brianschiffer/opencamera/README.md

# opencamera
an open hardware CCD camera
