brianschiffer/opencamera/KiCad/Power_Board/BOM.xlsx

REFDES | Count | Supplier | Supplier # | Part # | Description | Footprint | Part Count | Order Quantity | Spares | Boards Possible | Price | Board Total | Order Total
U4,U5,U6,U9 | 4 | Digikey | 296-39460-1-ND | TPS63030 | Buck-Boost Regulator with Vout=1.2 to 5.5V | CUSTOM (TPS63030) | 4 | 10 | 6 | 2 | $2.25 | $9.00 | $22.50
U8 | 1 | Digikey | ADP5070ACPZ-R7CT-ND | ADP5070 | +/-16V Boost Regulator | CUSTOM (ADP5070) | 1 | 2 | 1 | 2 | $5.99 | $5.99 | $11.98
U10 | 1 | Mouser | 584-ADP7142ACPZN-R7 | ADP7142 | LDO for 15V Line | CUSTOM (ADP7142) | 1 | 2 | 1 | 2 | $3.06 | $3.06 | $6.12
U11 | 1 | Mouser | 584-ADP7182ACPZ-R7 | ADP7182 | LDO for -15V line | CUSTOM (ADP7182) | 1 | 2 | 1 | 2 | $3.65 | $3.65 | $7.30
U12 | 1 | Digikey | ADP3335ACPZ-5-R7CT-ND | ADP3335 | 5V LDO | CUSTOM (ADP3335) | 1 | 2 | 1 | 2 | $2.76 | $2.76 | $5.52
U7 | 1 | Digikey | MAX1523EUT+TCT-ND | MAX1523 | 50V Boost | CUSTOM (SOT_623) | 1 | 2 | 1 | 2 | $3.84 | $3.84 | $7.68
U2,U3 | 2 | Digikey | MAX5259EEE+-ND | MAX5259 | 8 Channel 8bit DAC | CUSTOM (QSOP_16) | 2 | 4 | 2 | 2 | $2.82 | $5.64 | $11.28
U1 | 1 | Digikey | AD1583BRTZ-REEL7CT-ND | AD1583 | 3V Vref for DAC and Op-Amps | SOT_323 | 1 | 2 | 1 | 2 | $2.27 | $2.27 | $4.54
Q1 | 1 | Digikey | IRLL024NPBFCT-ND | IRLL024NTRPBF | N-Fet | SOT_223 | 1 | 3 | 2 | 3 | $0.93 | $0.93 | $2.79
D1,D3 | 2 | Digikey | DFLS240LDICT-ND | DFLS240 | Zener Diode | CUSTOM (DFLS240) | 2 | 5 | 3 | 2 | $0.46 | $0.92 | $2.30
D2 | 1 | Digikey | 1N4148WSFSCT-ND | 1N4148 | Diode | CUSTOM (1N4148) | 1 | 10 | 9 | 10 | $0.15 | $0.15 | $1.46
D4 | 1 | Digikey | 1N5261B-ND | 1N5261 | Diode | DO-35 | 1 | 10 | 9 | 10 | $0.12 | $0.12 | $1.17
L1,L2,L3, L5,L7 | 5 | Digikey | 587-3459-1-ND | NRS5030T3R3MMGJ | 3.3uH Inductor | CUSTOM (NRS5030) | 5 | 10 | 5 | 2 | $0.41 | $2.05 | $4.10
L6 | 1 | Digikey | 587-3462-1-ND | NRS5030T6R8MMGJ | 6.8uH Inductor | CUSTOM (NRS5030) | 1 | 3 | 2 | 3 | $0.46 | $0.46 | $1.38
L4 | 1 | Digikey | 587-2731-1-ND | NS12555T470MN | 47uH Inductor | CUSTOM (NS12555) | 1 | 2 | 1 | 2 | $1.41 | $1.41 | $2.82
R9,R10,R11,R22,R23,R30,R31,R32 | 8 | Digikey | 541-0.0TBCT-ND | CRCW08050000Z0EAHP | 0ohm Jumper | 0805 | 8 | 50 | 42 | 6 | $0.15 | $1.18 | $7.40
R28 | 1 | Digikey | 541-1.00KLCT-ND | CRCW04021K00FKED | 1k Resistor (1% 1/16W) | 0402 | 1 | 10 | 9 | 10 | $0.08 | $0.08 | $0.83
R12 | 1 | Digikey | 541-5.60KLCT-ND | CRCW04025K60FKED | 5.6k Resistor (1% 1/16W) | 0402 | 1 | 10 | 9 | 10 | $0.08 | $0.08 | $0.83
R1,R2,R26 | 3 | Digikey | 541-10.0KLCT-ND | CRCW040210K0FKED | 10k Resistor (1% 1/16W) | 0402 | 3 | 10 | 7 | 3 | $0.08 | $0.25 | $0.83
R13 | 1 | Digikey | 541-12.0KLCT-ND | CRCW040212K0FKED | 12k Resistor (1% 1/16W) | 0402 | 1 | 10 | 9 | 10 | $0.08 | $0.08 | $0.83
R24,R29 | 2 | Digikey | 541-13.0KLCT-ND | CRCW040213K0FKED | 13k Resistor (1% 1/16W) | 0402 | 2 | 10 | 8 | 5 | $0.08 | $0.17 | $0.83
R15 | 1 | Digikey | 541-100KLCT-ND | CRCW0402100KFKED | 100k Resistor (1% 1/16W) | 0402 | 1 | 10 | 9 | 10 | $0.08 | $0.08 | $0.83
R14 | 1 | Digikey | 541-113KLCT-ND | CRCW0402113KFKED | 113k Resistor (1% 1/16W) | 0402 | 1 | 10 | 9 | 10 | $0.08 | $0.08 | $0.83
R20 | 1 | Mouser | 71-CRCW0402-115K-E3 | CRCW0402115KFKED | 115k Resistor (1% 1/16W) | 0402 | 1 | 10 | 9 | 10 | $0.04 | $0.04 | $0.45
R27 | 1 | Digikey | 541-147KLCT-ND | CRCW0402147KFKED | 147k Resistor (1% 1/16W) | 0402 | 1 | 10 | 9 | 10 | $0.08 | $0.08 | $0.83
R6,R4 | 2 | Digikey | 541-200KLCT-ND | CRCW0402200KFKED | 200k Resistor (1% 1/16W) | 0402 | 2 | 10 | 8 | 5 | $0.08 | $0.17 | $0.83
R8,R18 | 2 | Digikey | 541-210KLCT-ND | CRCW0402210KFKED | 210k Resistor (1% 1/16W) | 0402 | 2 | 10 | 8 | 5 | $0.08 | $0.17 | $0.83
R21 | 1 | Digikey | 541-300KLCT-ND | CRCW0402300KFKED | 300k Resistor (1% 1/16W) | 0402 | 1 | 10 | 9 | 10 | $0.08 | $0.08 | $0.83
R3,R20 | 2 | Digikey | 541-523KLCT-ND | CRCW0402523KFKED | 523k Resistor (1% 1/16W) | 0402 | 2 | 10 | 8 | 5 | $0.08 | $0.17 | $0.83
R7 | 1 | Digikey | 541-1.20MLCT-ND | CRCW04021M20FKED | 1.2M Resistor (1% 1/16W) | 0402 | 1 | 10 | 9 | 10 | $0.08 | $0.08 | $0.83
R5 | 1 | Digikey | 541-1.80MLCT-ND | CRCW04021M80FKED | 1.8M Resistor (1% 1/16W) | 0402 | 1 | 10 | 9 | 10 | $0.08 | $0.08 | $0.83
R17,R19 | 2 | Digikey | 541-2.10MLCT-ND | CRCW04022M10FKED | 2.1M Resistor (1% 1/16W) | 0402 | 2 | 10 | 8 | 5 | $0.08 | $0.17 | $0.83
R16 | 1 | Digikey | 541-2.15MLCT-ND | CRCW04022M15FKED | 2.15M Resistor (1% 1/16W) | 0402 | 1 | 10 | 9 | 10 | $0.08 | $0.08 | $0.83
C31 | 1 | Digikey | 490-6390-1-ND | GRM1885C2A200JA01J | 20pF Cap (5% 100V NPO) | 0603 | 1 | 10 | 9 | 10 | $0.08 | $0.08 | $0.83
C35,C36 | 2 | Digikey | 490-6349-1-ND | GRM155R71H102JA01J | 1nF Cap (5% 50V X7R) | 0402 | 2 | 10 | 8 | 5 | $0.01 | $0.02 | $0.12
C20,C21 | 2 | Digikey | 490-7762-1-ND | GRM155R71E473JA88D | 47nF Cap (5% 25V X7R) | 0402 | 2 | 10 | 8 | 5 | $0.07 | $0.14 | $0.71
C2,C5,C7,C11,C12,C13,C25,C39 | 8 | Digikey | 490-9691-1-ND | GRM188R71E104JA01J | 0.1uF Cap (5% 25V X7R) | 0603 | 8 | 50 | 42 | 6 | $0.05 | $0.37 | $2.33
C3,C4,C6,C23,C26,C32,C38 | 7 | Digikey | 490-5307-1-ND | GRM188R71E105KA12D | 1uF Cap (10% 25V X7R) | 0603 | 7 | 50 | 43 | 7 | $0.13 | $0.91 | $6.53
C34 | 1 | Digikey | 490-3909-1-ND | GRM31CR72A105KA01L | 1uF Cap (10% 100V X7R) | 1206 | 1 | 10 | 9 | 10 | $0.51 | $0.51 | $5.13
C33,C40,C41 | 3 | Digikey | 490-3331-1-ND | GRM21BR71E225KA73L | 2.2uF Cap (10% 25V X7R) | 0805 | 3 | 10 | 7 | 3 | $0.56 | $1.67 | $5.56
C1 | 1 | Digikey | 490-9962-1-ND | GRM21BR71E475KA73L | 4.7uF Cap (10% 25V X7R) | 0805 | 1 | 10 | 9 | 10 | $0.42 | $0.42 | $4.19
C8,C9,C10,C14,C15,C16,C17,C18,C19,C24,C27,C28,C37,C22,C29,C30 | 16 | Digikey | 490-6544-1-ND | GRM32ER71H106KA12L | 10uF Cap (10% 25V X7R) | 1210 | 16 | 50 | 34 | 3 | $0.42 | $6.66 | $20.80
TP1,Tp2,Tp3,TP4,TP5,TP6,TP7,TP8 | 8 | Digikey | EXAMPLE: 36-5001-ND | MANY COLORS | Test Clip (Low Profile) | CUSTOM (TEST_CLIP) | 8 | 30 | 22 | 3 | $0.33 | $2.62 | $9.81
P5,P6,P7,P8,P9,P10 | 6 | Digikey | S1133E-36-ND | GBC36SBSN-M89 | Low Profile 2pin Header | CUSTOM (SMD_JUMPER) | 6 | 1 | -5 | 0 | $5.56 | $5.56 | $5.56
Total |  |  |  |  |  |  |  |  |  |  |  | $64.35 | $175.64
