brianschiffer/opencamera/KiCad/Battery_Board/BOM.xlsx

REFDES | Count | Supplier | Supplier # | Part # | Description | Footprint | Part Count | Order Quantity | Spares | Boards Possible | Price | Board Total | Order Total
U1 | 1 | Mouser | 595-BQ24230RGTR | BQ24230 | LiPo USB-Friendly Charger w/ Power Path | CUSTOM (BQ24230) | 1 | 3 | 2 | 3 | $2.87 | $2.87 | $8.61
U2 | 1 | Mouser | 700-MAX17043G+U | MAX17043 | LiPo Host-Side Fuel Gauge | CUSTOM (MAX17043) | 1 | 3 | 2 | 3 | $2.69 | $2.69 | $8.07
D1 | 1 | Mouser | 604-APBA3010ESGC-GX | APBA3010ESGC-GX | Red-Green BiColor LED | CUSTOM(RG_LED) | 1 | 10 | 9 | 10 | $0.22 | $0.22 | $2.24
R7,R15 | 2 | Digikey | 541-0.0TBCT-ND | CRCW08050000Z0EAHP | 0ohm Jumper | 0805 | 2 | 0 | -2 | 0 | $0.15 | $0.30 | $0.00
R6 | 1 | Mouser | 71-CRCW0402-150-E3 | CRCW0402150RFKED | 150ohm Resistor (1% 1/16W) | 0402 | 1 | 10 | 9 | 10 | $0.04 | $0.04 | $0.45
R2 | 1 | Digikey | 541-1.00KLCT-ND | CRCW04021K00FKED | 1k Resistor (1% 1/16W) | 0402 | 1 | 0 | -1 | 0 | $0.08 | $0.08 | $0.00
R9,R10 | 2 | Mouser | 71-CRCW0402-1.5K-E3 | CRCW04021K50FKED | 1.5k Resistor (1% 1/16W) | 0402 | 2 | 10 | 8 | 5 | $0.04 | $0.09 | $0.45
R3 | 1 | Mouser | 71-CRCW0402-1.74K-E3 | CRCW04021K74FKED | 1.74k (1% 1/16W) | 0402 | 1 | 10 | 9 | 10 | $0.04 | $0.04 | $0.45
R1 | 1 | Digikey | 541-10.0KLCT-ND | CRCW040210K0FKED | 10k Resistor (1% 1/16W) | 0402 | 1 | 0 | -1 | 0 | $0.08 | $0.08 | $0.00
C4 | 1 | Mouser | 81-GRM39X103K25 | GRM188R71E103KA01D | 10nF Cap (10% 25V X7R) | 0603 | 1 | 10 | 9 | 10 | $0.01 | $0.01 | $0.13
C1,C3 | 2 | Digikey | 490-5307-1-ND | GRM188R71E105KA12D | 1uF Cap (10% 25V X7R) | 0603 | 2 | 0 | -2 | 0 | $0.13 | $0.26 | $0.00
C2,C5 | 2 | Digikey | 490-9962-1-ND | GRM21BR71E475KA73L | 4.7uF Cap (10% 25V X7R) | 0805 | 2 | 0 | -2 | 0 | $0.42 | $0.84 | $0.00
SW1 | 1 | Mouser | 642-GH36WW10001 | GH36W0 | Through-Hole Switch | CUSTOM(SWITCH_SPST) | 1 | 2 | 1 | 2 | $5.99 | $5.99 | $11.98
P5 | 1 | Sparkfun | PRT-08612 | PRT-08612 | JST LiPo Connector | CUSTOM(JST-2) | 1 | 4 | 3 | 4 | $0.95 | $0.95 | $3.80
USB1 | 1 | Mouser | 798-ZX62-B-5PA11 | ZX62-B-5PA(11) | Micro USB B Receptacle | CUSTOM(MicroUBS-B-Receptacle) | 1 | 10 | 9 | 10 | $0.69 | $0.69 | $6.90
Battery | 1 | Sparkfun | PRT-00339 | PRT-00339 | 1000mAh LiPo Battery | NONE | 1 | 2 | 1 | 2 | $9.95 | $9.95 | $19.90
Total | 1 |  |  |  |  |  |  |  |  |  |  | $25.11 | $62.98
