brianschiffer/opencamera/KiCad/Driver_Board/Driver_Board.kicad_pcb

## KiCad design KiCad/Driver_Board/Driver_Board.kicad_pcb (2015-12-30)

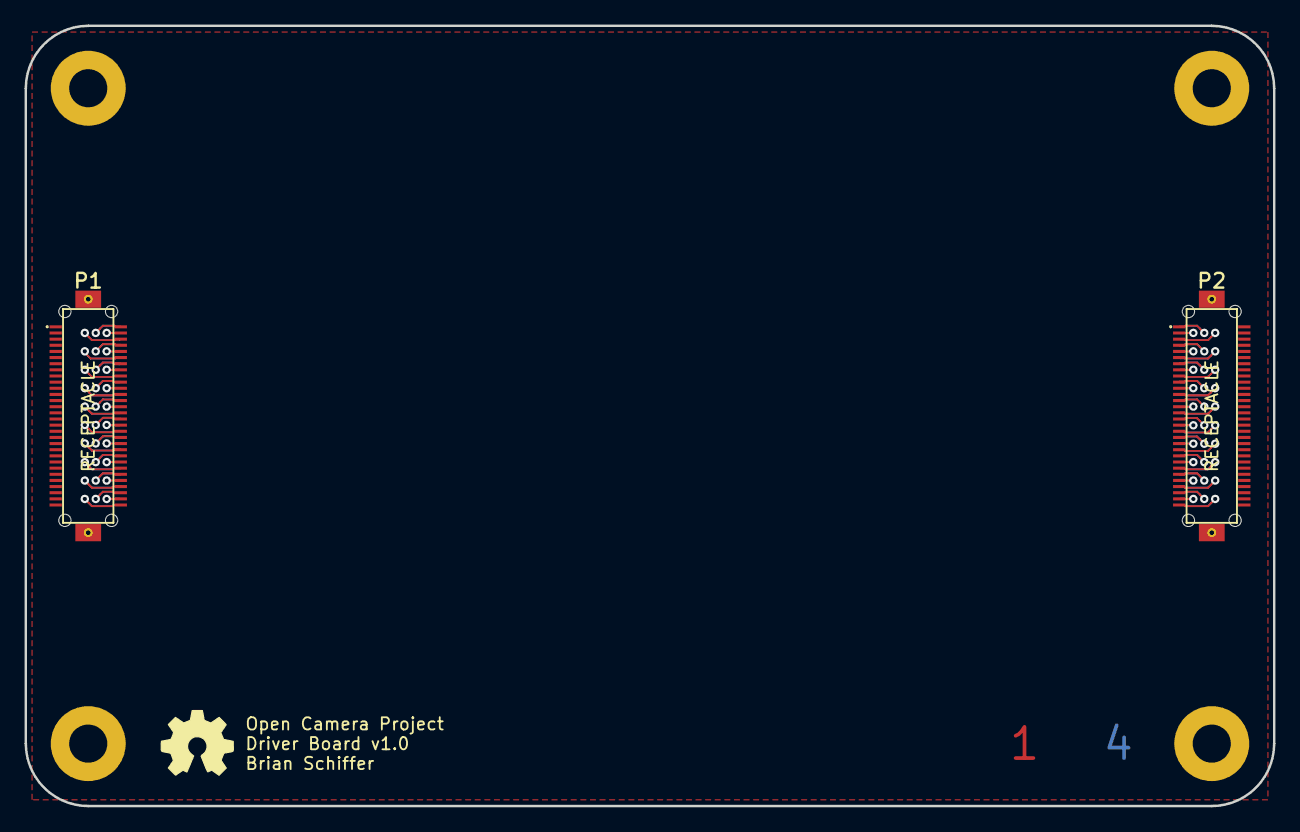
[picture p1: board Driver_Board.kicad_pcb from above]

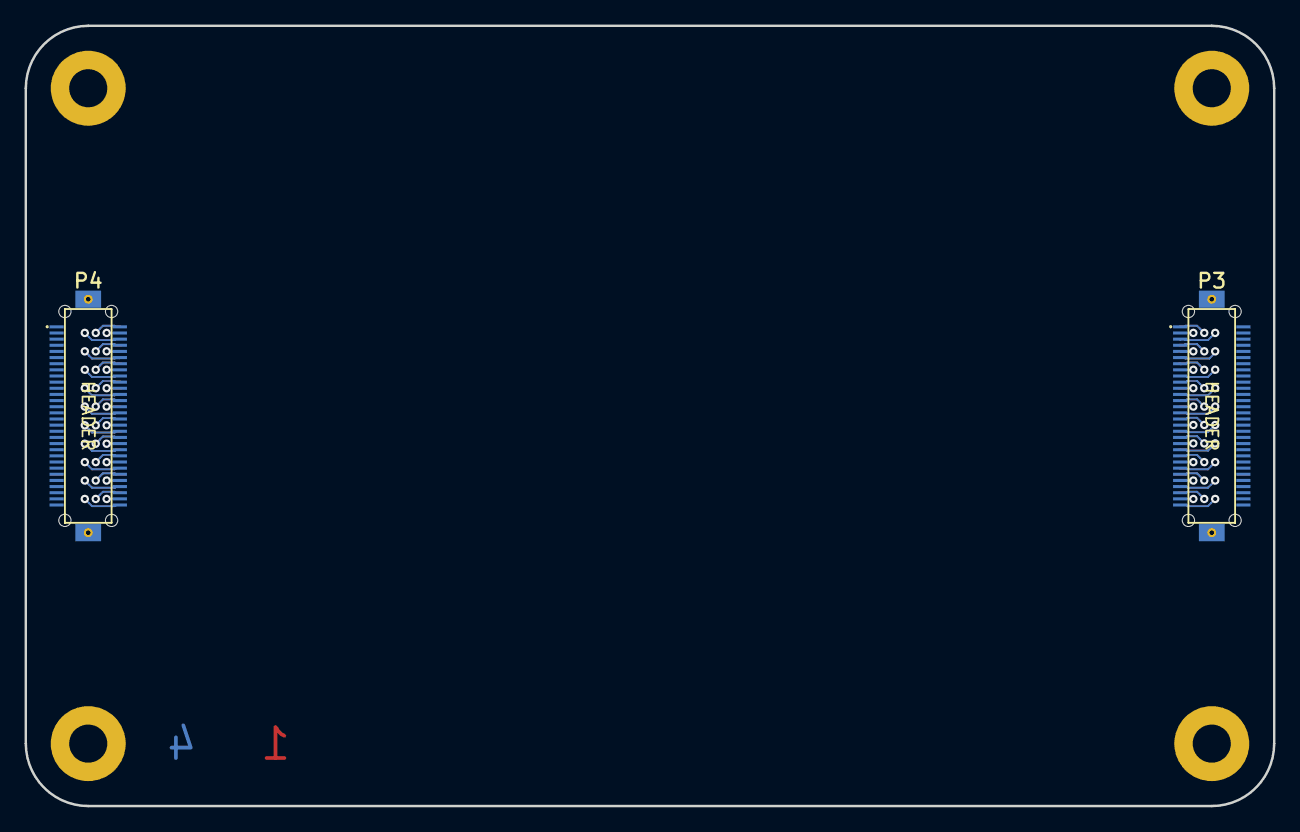
[picture p2: board Driver_Board.kicad_pcb from below]

Board: 4 copper layers, 101.6 x 63.5 mm, 4 parts (2 on the bottom side), 62 nets.

Parts:
P1: CONN_LEFT_TOP; DF17_60_RECEPTACLE
P2: CONN_RIGHT_TOP; DF17_60_RECEPTACLE
P3: CONN_LEFT_BOTTOM; DF17_60_HEADER
P4: CONN_RIGHT_BOTTOM; DF17_60_HEADER

Connections:
/connectors/L1: P1.2, P3.1
/connectors/L2: P1.4, P3.3
/connectors/L3: P1.6, P3.5
/connectors/L4: P1.8, P3.7
/connectors/L5: P1.10, P3.9
/connectors/L6: P1.12, P3.11
/connectors/L7: P1.14, P3.13
/connectors/L8: P1.16, P3.15
/connectors/L9: P1.18, P3.17
/connectors/L10: P1.20, P3.19
/connectors/L11: P1.22, P3.21
/connectors/L12: P1.24, P3.23
/connectors/L13: P1.26, P3.25
/connectors/L14: P1.28, P3.27
/connectors/L15: P1.30, P3.29
/connectors/L16: P1.32, P3.31
/connectors/L17: P1.34, P3.33
/connectors/L18: P1.36, P3.35
/connectors/L19: P1.38, P3.37
/connectors/L20: P1.40, P3.39
/connectors/L21: P1.42, P3.41
/connectors/L22: P1.44, P3.43
/connectors/L23: P1.46, P3.45
/connectors/L24: P1.48, P3.47
/connectors/L25: P1.50, P3.49
/connectors/L26: P1.52, P3.51
/connectors/L27: P1.54, P3.53
/connectors/L28: P1.56, P3.55
/connectors/L29: P1.58, P3.57
/connectors/L30: P1.60, P3.59
/connectors/R1: P2.1, P4.2
/connectors/R2: P2.3, P4.4
/connectors/R3: P2.5, P4.6
/connectors/R4: P2.7, P4.8
/connectors/R5: P2.9, P4.10
/connectors/R6: P2.11, P4.12
/connectors/R7: P2.13, P4.14
/connectors/R8: P2.15, P4.16
/connectors/R9: P2.17, P4.18
/connectors/R10: P2.19, P4.20
/connectors/R11: P2.21, P4.22
/connectors/R12: P2.23, P4.24
/connectors/R13: P2.25, P4.26
/connectors/R14: P2.27, P4.28
/connectors/R15: P2.29, P4.30
/connectors/R16: P2.31, P4.32
/connectors/R17: P2.33, P4.34
/connectors/R18: P2.35, P4.36
/connectors/R19: P2.37, P4.38
/connectors/R20: P2.39, P4.40
/connectors/R21: P2.41, P4.42
/connectors/R22: P2.43, P4.44
/connectors/R23: P2.45, P4.46
/connectors/R24: P2.47, P4.48
/connectors/R25: P2.49, P4.50
/connectors/R26: P2.51, P4.52
/connectors/R27: P2.53, P4.54
/connectors/R28: P2.55, P4.56
/connectors/R29: P2.57, P4.58
/connectors/R30: P2.59, P4.60
GNDA: P2.2, P2.4, P2.6, P2.8, P2.10, P2.12, P2.14, P2.16, P2.18, P2.20, P2.22, P2.24, P2.26, P2.28, P2.30, P2.32, P2.34, P2.36, P2.38, P2.40, P2.42, P2.44, P2.46, P2.48, P2.50, P2.52, P2.54, P2.56, P2.58, P2.60, P2.61, P2.62, P4.1, P4.3, P4.5, P4.7, P4.9, P4.11, P4.13, P4.15, P4.17, P4.19, P4.21, P4.23, P4.25, P4.27, P4.29, P4.31, P4.33, P4.35, P4.37, P4.39, P4.41, P4.43, P4.45, P4.47, P4.49, P4.51, P4.53, P4.55, P4.57, P4.59, P4.61, P4.62
GNDD: P1.1, P1.3, P1.5, P1.7, P1.9, P1.11, P1.13, P1.15, P1.17, P1.19, P1.21, P1.23, P1.25, P1.27, P1.29, P1.31, P1.33, P1.35, P1.37, P1.39, P1.41, P1.43, P1.45, P1.47, P1.49, P1.51, P1.53, P1.55, P1.57, P1.59, P1.61, P1.62, P3.2, P3.4, P3.6, P3.8, P3.10, P3.12, P3.14, P3.16, P3.18, P3.20, P3.22, P3.24, P3.26, P3.28, P3.30, P3.32, P3.34, P3.36, P3.38, P3.40, P3.42, P3.44, P3.46, P3.48, P3.50, P3.52, P3.54, P3.56, P3.58, P3.60, P3.61, P3.62
