brianschiffer/opencamera/KiCad/Debug_Board/v1.0/Debug_Board.kicad_pcb

## KiCad design KiCad/Debug_Board/v1.0/Debug_Board.kicad_pcb (2015-06-25)

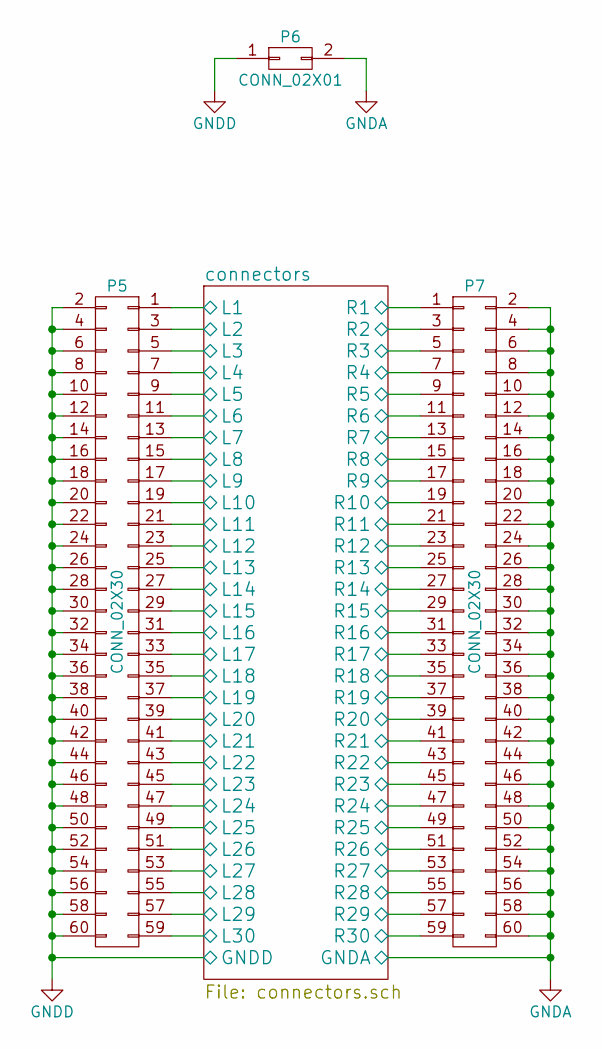
[picture p3: schematic Debug_Board.sch, Debug Board]

Parts:
P5, P7: CONN_02X30
P6: CONN_02X01

Connections:
/connectors/L1: P5.1; also elsewhere on the board
/connectors/L2: P5.3; also elsewhere on the board
/connectors/L3: P5.5; also elsewhere on the board
/connectors/L4: P5.7; also elsewhere on the board
/connectors/L5: P5.9; also elsewhere on the board
/connectors/L6: P5.11; also elsewhere on the board
/connectors/L7: P5.13; also elsewhere on the board
/connectors/L8: P5.15; also elsewhere on the board
/connectors/L9: P5.17; also elsewhere on the board
/connectors/L10: P5.19; also elsewhere on the board
/connectors/L11: P5.21; also elsewhere on the board
/connectors/L12: P5.23; also elsewhere on the board
/connectors/L13: P5.25; also elsewhere on the board
/connectors/L14: P5.27; also elsewhere on the board
/connectors/L15: P5.29; also elsewhere on the board
/connectors/L16: P5.31; also elsewhere on the board
/connectors/L17: P5.33; also elsewhere on the board
/connectors/L18: P5.35; also elsewhere on the board
/connectors/L19: P5.37; also elsewhere on the board
/connectors/L20: P5.39; also elsewhere on the board
/connectors/L21: P5.41; also elsewhere on the board
/connectors/L22: P5.43; also elsewhere on the board
/connectors/L23: P5.45; also elsewhere on the board
/connectors/L24: P5.47; also elsewhere on the board
/connectors/L25: P5.49; also elsewhere on the board
/connectors/L26: P5.51; also elsewhere on the board
/connectors/L27: P5.53; also elsewhere on the board
/connectors/L28: P5.55; also elsewhere on the board
/connectors/L29: P5.57; also elsewhere on the board
/connectors/L30: P5.59; also elsewhere on the board
/connectors/R1: P7.1; also elsewhere on the board
/connectors/R2: P7.3; also elsewhere on the board
/connectors/R3: P7.5; also elsewhere on the board
/connectors/R4: P7.7; also elsewhere on the board
/connectors/R5: P7.9; also elsewhere on the board
/connectors/R6: P7.11; also elsewhere on the board
/connectors/R7: P7.13; also elsewhere on the board
/connectors/R8: P7.15; also elsewhere on the board
/connectors/R9: P7.17; also elsewhere on the board
/connectors/R10: P7.19; also elsewhere on the board
/connectors/R11: P7.21; also elsewhere on the board
/connectors/R12: P7.23; also elsewhere on the board
/connectors/R13: P7.25; also elsewhere on the board
/connectors/R14: P7.27; also elsewhere on the board
/connectors/R15: P7.29; also elsewhere on the board
/connectors/R16: P7.31; also elsewhere on the board
/connectors/R17: P7.33; also elsewhere on the board
/connectors/R18: P7.35; also elsewhere on the board
/connectors/R19: P7.37; also elsewhere on the board
/connectors/R20: P7.39; also elsewhere on the board
/connectors/R21: P7.41; also elsewhere on the board
/connectors/R22: P7.43; also elsewhere on the board
/connectors/R23: P7.45; also elsewhere on the board
/connectors/R24: P7.47; also elsewhere on the board
/connectors/R25: P7.49; also elsewhere on the board
/connectors/R26: P7.51; also elsewhere on the board
/connectors/R27: P7.53; also elsewhere on the board
/connectors/R28: P7.55; also elsewhere on the board
/connectors/R29: P7.57; also elsewhere on the board
/connectors/R30: P7.59; also elsewhere on the board
GNDA: P6.2, P7.2, P7.4, P7.6, P7.8, P7.10, P7.12, P7.14, P7.16, P7.18, P7.20, P7.22, P7.24, P7.26, P7.28, P7.30, P7.32, P7.34, P7.36, P7.38, P7.40, P7.42, P7.44, P7.46, P7.48, P7.50, P7.52, P7.54, P7.56, P7.58, P7.60; also elsewhere on the board
GNDD: P5.2, P5.4, P5.6, P5.8, P5.10, P5.12, P5.14, P5.16, P5.18, P5.20, P5.22, P5.24, P5.26, P5.28, P5.30, P5.32, P5.34, P5.36, P5.38, P5.40, P5.42, P5.44, P5.46, P5.48, P5.50, P5.52, P5.54, P5.56, P5.58, P5.60, P6.1; also elsewhere on the board

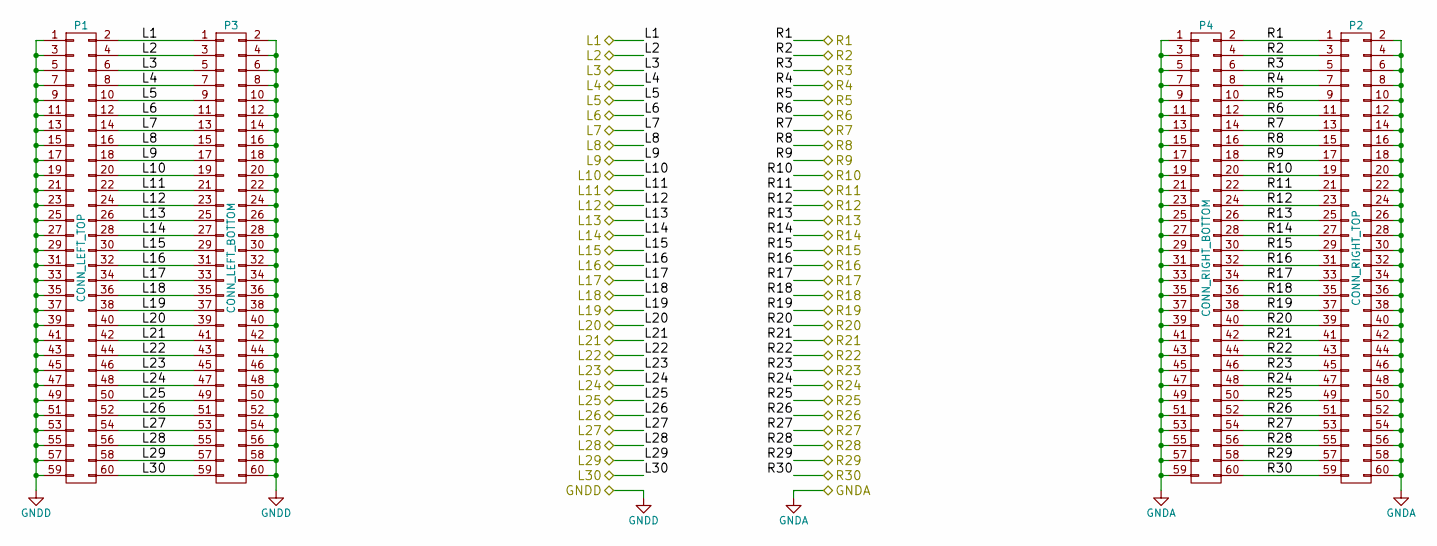
[picture p4: schematic connectors.sch, Board-Board Connectors]

Parts:
P1: CONN_LEFT_TOP; DF17_60_RECEPTACLE
P2: CONN_RIGHT_TOP; DF17_60_RECEPTACLE
P3: CONN_LEFT_BOTTOM; DF17_60_HEADER
P4: CONN_RIGHT_BOTTOM; DF17_60_HEADER

Connections:
/connectors/L1: P1.2, P3.1; also elsewhere on the board
/connectors/L2: P1.4, P3.3; also elsewhere on the board
/connectors/L3: P1.6, P3.5; also elsewhere on the board
/connectors/L4: P1.8, P3.7; also elsewhere on the board
/connectors/L5: P1.10, P3.9; also elsewhere on the board
/connectors/L6: P1.12, P3.11; also elsewhere on the board
/connectors/L7: P1.14, P3.13; also elsewhere on the board
/connectors/L8: P1.16, P3.15; also elsewhere on the board
/connectors/L9: P1.18, P3.17; also elsewhere on the board
/connectors/L10: P1.20, P3.19; also elsewhere on the board
/connectors/L11: P1.22, P3.21; also elsewhere on the board
/connectors/L12: P1.24, P3.23; also elsewhere on the board
/connectors/L13: P1.26, P3.25; also elsewhere on the board
/connectors/L14: P1.28, P3.27; also elsewhere on the board
/connectors/L15: P1.30, P3.29; also elsewhere on the board
/connectors/L16: P1.32, P3.31; also elsewhere on the board
/connectors/L17: P1.34, P3.33; also elsewhere on the board
/connectors/L18: P1.36, P3.35; also elsewhere on the board
/connectors/L19: P1.38, P3.37; also elsewhere on the board
/connectors/L20: P1.40, P3.39; also elsewhere on the board
/connectors/L21: P1.42, P3.41; also elsewhere on the board
/connectors/L22: P1.44, P3.43; also elsewhere on the board
/connectors/L23: P1.46, P3.45; also elsewhere on the board
/connectors/L24: P1.48, P3.47; also elsewhere on the board
/connectors/L25: P1.50, P3.49; also elsewhere on the board
/connectors/L26: P1.52, P3.51; also elsewhere on the board
/connectors/L27: P1.54, P3.53; also elsewhere on the board
/connectors/L28: P1.56, P3.55; also elsewhere on the board
/connectors/L29: P1.58, P3.57; also elsewhere on the board
/connectors/L30: P1.60, P3.59; also elsewhere on the board
/connectors/R1: P2.1, P4.2; also elsewhere on the board
/connectors/R2: P2.3, P4.4; also elsewhere on the board
/connectors/R3: P2.5, P4.6; also elsewhere on the board
/connectors/R4: P2.7, P4.8; also elsewhere on the board
/connectors/R5: P2.9, P4.10; also elsewhere on the board
/connectors/R6: P2.11, P4.12; also elsewhere on the board
/connectors/R7: P2.13, P4.14; also elsewhere on the board
/connectors/R8: P2.15, P4.16; also elsewhere on the board
/connectors/R9: P2.17, P4.18; also elsewhere on the board
/connectors/R10: P2.19, P4.20; also elsewhere on the board
/connectors/R11: P2.21, P4.22; also elsewhere on the board
/connectors/R12: P2.23, P4.24; also elsewhere on the board
/connectors/R13: P2.25, P4.26; also elsewhere on the board
/connectors/R14: P2.27, P4.28; also elsewhere on the board
/connectors/R15: P2.29, P4.30; also elsewhere on the board
/connectors/R16: P2.31, P4.32; also elsewhere on the board
/connectors/R17: P2.33, P4.34; also elsewhere on the board
/connectors/R18: P2.35, P4.36; also elsewhere on the board
/connectors/R19: P2.37, P4.38; also elsewhere on the board
/connectors/R20: P2.39, P4.40; also elsewhere on the board
/connectors/R21: P2.41, P4.42; also elsewhere on the board
/connectors/R22: P2.43, P4.44; also elsewhere on the board
/connectors/R23: P2.45, P4.46; also elsewhere on the board
/connectors/R24: P2.47, P4.48; also elsewhere on the board
/connectors/R25: P2.49, P4.50; also elsewhere on the board
/connectors/R26: P2.51, P4.52; also elsewhere on the board
/connectors/R27: P2.53, P4.54; also elsewhere on the board
/connectors/R28: P2.55, P4.56; also elsewhere on the board
/connectors/R29: P2.57, P4.58; also elsewhere on the board
/connectors/R30: P2.59, P4.60; also elsewhere on the board
GNDA: P2.2, P2.4, P2.6, P2.8, P2.10, P2.12, P2.14, P2.16, P2.18, P2.20, P2.22, P2.24, P2.26, P2.28, P2.30, P2.32, P2.34, P2.36, P2.38, P2.40, P2.42, P2.44, P2.46, P2.48, P2.50, P2.52, P2.54, P2.56, P2.58, P2.60, P4.1, P4.3, P4.5, P4.7, P4.9, P4.11, P4.13, P4.15, P4.17, P4.19, P4.21, P4.23, P4.25, P4.27, P4.29, P4.31, P4.33, P4.35, P4.37, P4.39, P4.41, P4.43, P4.45, P4.47, P4.49, P4.51, P4.53, P4.55, P4.57, P4.59; also elsewhere on the board
GNDD: P1.1, P1.3, P1.5, P1.7, P1.9, P1.11, P1.13, P1.15, P1.17, P1.19, P1.21, P1.23, P1.25, P1.27, P1.29, P1.31, P1.33, P1.35, P1.37, P1.39, P1.41, P1.43, P1.45, P1.47, P1.49, P1.51, P1.53, P1.55, P1.57, P1.59, P3.2, P3.4, P3.6, P3.8, P3.10, P3.12, P3.14, P3.16, P3.18, P3.20, P3.22, P3.24, P3.26, P3.28, P3.30, P3.32, P3.34, P3.36, P3.38, P3.40, P3.42, P3.44, P3.46, P3.48, P3.50, P3.52, P3.54, P3.56, P3.58, P3.60; also elsewhere on the board

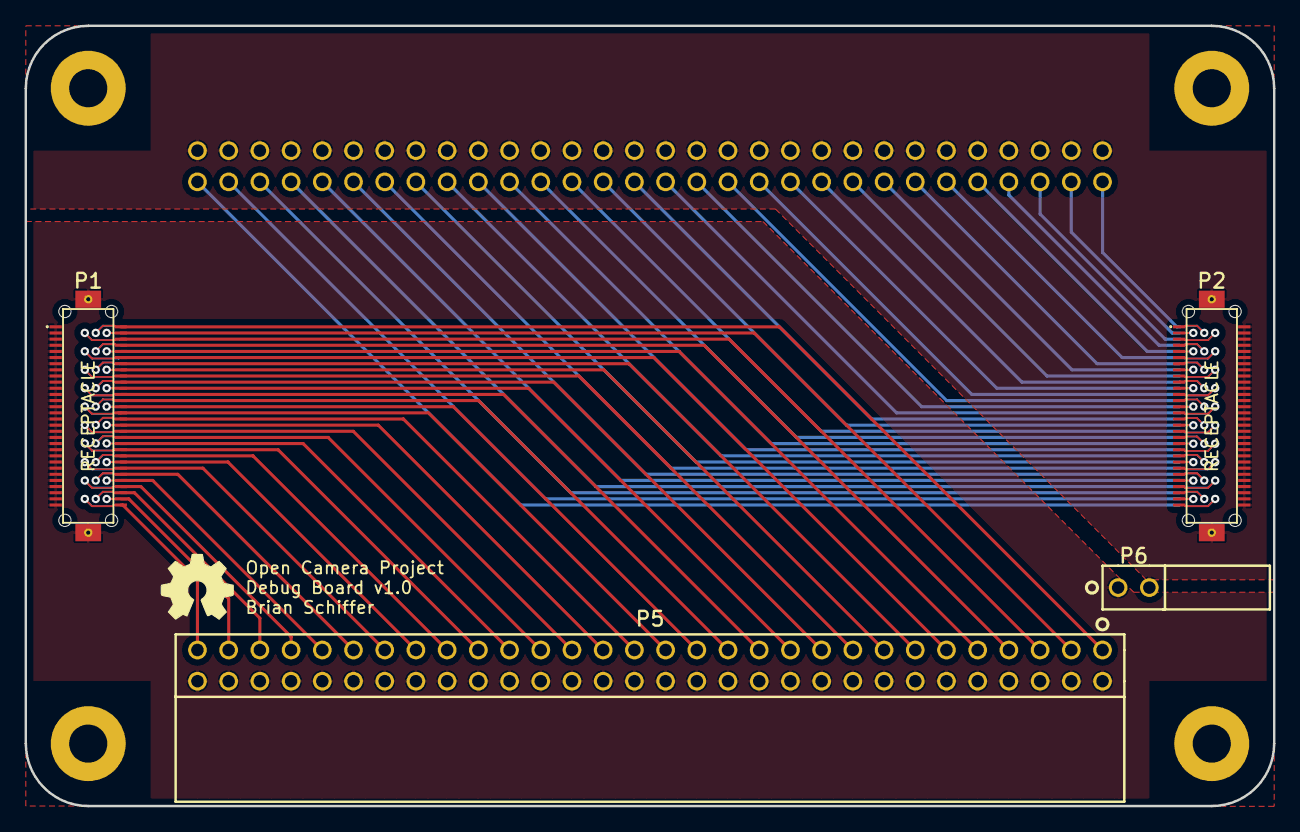
[picture p5: board Debug_Board.kicad_pcb from above]

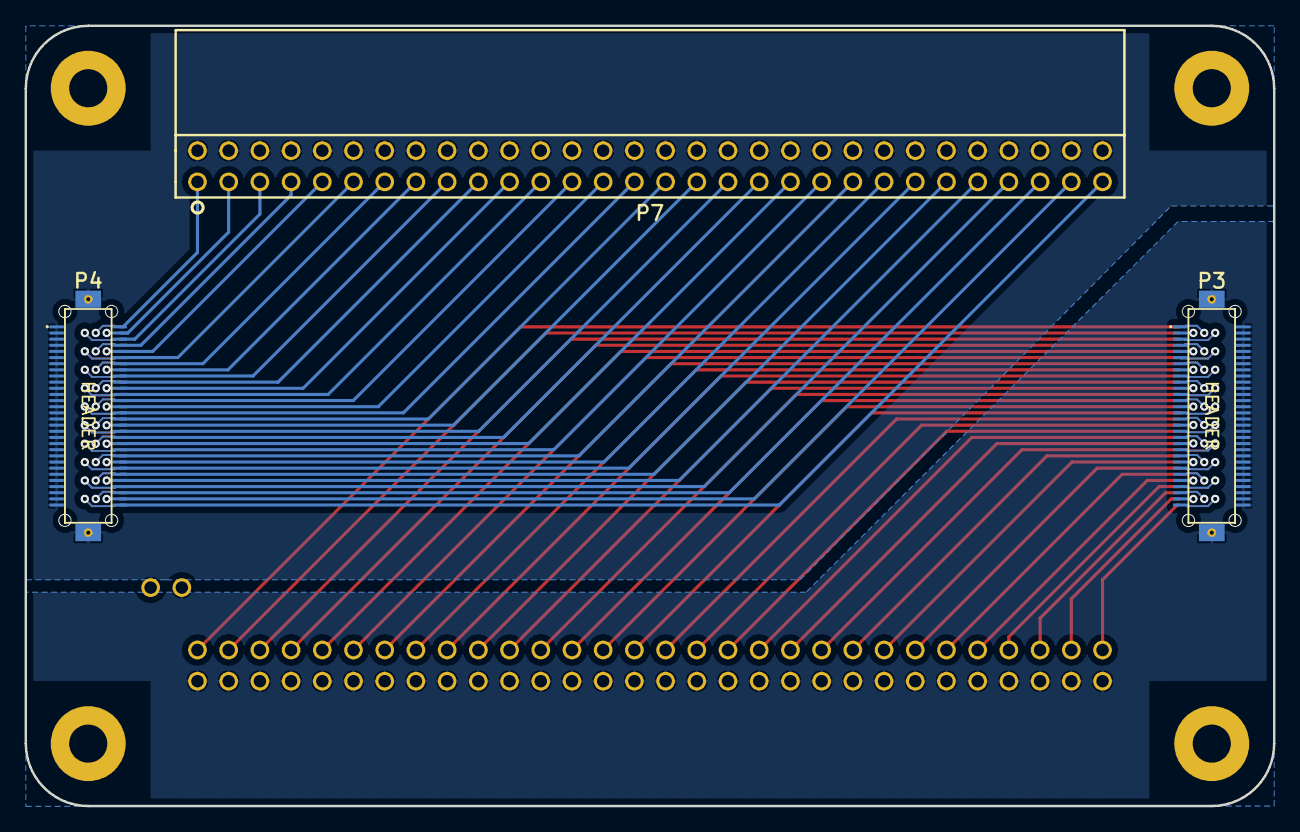
[picture p6: board Debug_Board.kicad_pcb from below]

Board: 4 copper layers, 101.6 x 63.5 mm, 7 parts (3 on the bottom side), 62 nets.
