brianschiffer/opencamera/(commit log)

2015-06-03 Added KAI2020 CCD Datasheets & Application Notes.
    For the first version of the open camera, I am planning on using the
    KAI2020 CCD.
2015-06-07 Initial KiCad Folder & Template Draft
    [Template.kicad_pcb, Template.sch]
2015-06-07 Update template with connectors & keep-outs.
    Also fixed the naming scheme.
    [Template.kicad_pcb, Template.sch, connectors.sch, opencamera-default.kicad_pcb, opencamera-default.sch]
2015-06-07 Connected the connectors from front to back on template.
    [opencamera-default.kicad_pcb]
2015-06-09 Initial Debug Board Draft.
    Created & routed the debug board.
    Created a stitching via footprint for stitching ground planes.
    Edited template board to ground the board-board connectors and add
    stitching vias through the mounting pads.
    [$Debug_Board.sch, Debug_Board.kicad_pcb, Debug_Board.sch, connectors.sch, opencamera-default.kicad_pcb]
2015-06-10 Cleaned up ground plane on debug board & generated gerbers.
    [Debug_Board-B_Cu.gbl, Debug_Board-B_Mask.gbs, Debug_Board-B_SilkS.gbo, Debug_Board-Edge_Cuts.gbr, Debug_Board-F_Cu.gtl, Debug_Board-F_Mask.gts, Debug_Board-F_SilkS.gto, Debug_Board.drl]
2015-06-11 Updated board-board connectors with mounting holes.
    THIS IS THE VERSION SENT TO FAB ON JUNE 10 2015.
    [Debug_Board-B_Cu.gbl, Debug_Board-B_Mask.gbs, Debug_Board-B_SilkS.gbo, Debug_Board-Edge_Cuts.gbr, Debug_Board-F_Cu.gtl, Debug_Board-F_Mask.gts, Debug_Board-F_SilkS.gto, Debug_Board.drl]
2015-06-13 Update Template
    v1.1
    Removed keepouts around mounting holes (looks nicer).
    Modified board-board connectors to include grounded mounting pads with
    through via.
    Created test point footprints.
    Added 1,2,3,4 layer text to confirm proper stackup when receiving from
    fab.
    [connectors.sch, opencamera-default.kicad_pcb]
2015-06-25 Reorginization
    A bit of cleanup + part selection for the power board.
    [$Debug_Board.sch, BOM.xlsx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]
2015-06-25 Power board started
    Created some schematic symbols for power board parts.
    Also, started the hierarchy sheets.
    [$Debug_Board.sch, Analog_Power.sch, BOM.xlsx, Debug_Board.sch, Digital_Power.sch, Power_Board.kicad_pcb, Power_Board.sch, connectors.sch]
2015-06-28 Updated power board schematic.
    Initial schematic draft. Probably will be modified once layout is
    started.
    [Analog_Power.sch, Digital_Power.sch, LT8570_Calculator.xlsx, Power_Board.sch]
2015-06-30 Power board fixes & Updated BOM
    Initialized refdes.
    Added test clip test points to all power lines (except DACs).
    Fixed a feedback resistor mess up on the +/-15V LDOs.
    [Analog_Power.sch, BOM.xlsx, Digital_Power.sch, LT8570_Calculator.xlsx, Power_Board.sch, connectors.sch]
2015-06-30 Selected some BOM components.
    [BOM.xlsx]
2015-07-01 Fixed -15V LDO & Updated BOM
    -15V LDO had incorrect feedback resistors. +15V LDO seemed ok.
    BOM updated to all tentatively selected parts.
    [Analog_Power.sch, BOM.xlsx, Digital_Power.sch]
2015-07-03 Updated BOM & Schematic
    BOM was too high.
    Switched to a cheaper 8bit DAC. This will still yield ~0.06V resolution
    when gained up to +15V.
    Currently leaving power circuits alone, but in the future this could be
    better optimized for space and cost. Multichannel buck PMIC would be a
    good option to simplify the digital supplies.
    [Analog_Power.sch, BOM.xlsx, Digital_Power.sch, Power_Board.sch, connectors.sch]
2015-07-04 Created TPS63030 footprint.
    Also updated PCB sheet.
    [Power_Board.kicad_pcb]
2015-07-04 Created all of the custom footprints necessary.
    Also updated the BOM to include the footprints used.
    [BOM.xlsx, Power_Board.kicad_pcb]
2015-07-04 Linked footprints to schematic.
    Also cleaned up some footprint errors:
    Changed IC footprint names to be invisible on the silkscreen layer.
    Fixed test points that were lacking pin numbers causing netlist
    failures.
    [Analog_Power.sch, BOM.xlsx, Digital_Power.sch, Power_Board.kicad_pcb, Power_Board.sch, connectors.sch]
2015-07-04 Rough PCB component placement.
    Organized parts by module and roughly placed them in appropriate
    locations on the board.
    Also fixed a couple of test points that weren't properly connected to a
    net.
    [Analog_Power.sch, Power_Board.kicad_pcb]
2015-07-05 Added a reserved MISO pin on the board-board connectors for future SPI devices.
    [Power_Board.sch]
2015-07-05 Connected GND & GNDA since this is the power board which supplies both.
    [Power_Board.kicad_pcb, Power_Board.sch]
2015-07-05 Removed redundant SMD test points where test clips are being used.
    [Analog_Power.sch, Digital_Power.sch, Power_Board.sch, connectors.sch]
2015-07-05 Some layout progress.
    Properly placed and oriented parts for compact layout of individual
    modules.
    Added zones of copper around the converters as appropriate.
    [Analog_Power.sch, Power_Board.kicad_pcb, Power_Board.sch]
2015-07-06 All nets routed! No DRC errors.
    Still needs some cleanup:
    -Check ground plane continuity.
    -Thicken power traces where possible.
    -Move SPI lines out of the way.
    [Power_Board.kicad_pcb]
2015-07-06 Added a Vin test clip.
    Also did a bit of copper pour cutout cleanup.
    [Power_Board.kicad_pcb, Power_Board.sch]
2015-07-06 Component changes
    Switched Vref test point to test clip.
    Beefed up 0ohm jumpers to 0805.
    [Analog_Power.sch, BOM.xlsx, Digital_Power.sch, Power_Board.kicad_pcb, Power_Board.sch]
2015-07-06 Ground plane cutout cleanup.
    [Power_Board.kicad_pcb]
2015-07-07 SPI Trace Cleanup
    [Power_Board.kicad_pcb]
2015-07-07 More SPI Cleanup.
    [Power_Board.kicad_pcb]
2015-07-07 Thickened Power Traces.
    [Power_Board.kicad_pcb]
2015-07-07 Pulled ground pour back to ensure 20mil clearance to board edge.
    [Power_Board.kicad_pcb]
2015-07-07 Placed a bunch of ground plane stitching vias.
    [Power_Board.kicad_pcb]
2015-07-07 Fixed missing links between ground vias for some of the thermal pads.
    [Power_Board.kicad_pcb]
2015-07-07 More Cleanup
    -Moved some traces away from the inductors to help with ground plane
    continuity
    -Increased via size in power traces
    -Labeled power jumpers
    [Power_Board.kicad_pcb]
2015-07-08 Added more ground vias around SPI lines.
    [Power_Board.kicad_pcb]
2015-07-08 Gerbers generated and sent to Fab!
    [Power_Board-B_Cu.gbl, Power_Board-B_Mask.gbs, Power_Board-B_SilkS.gbo, Power_Board-Edge_Cuts.gbr, Power_Board-F_Cu.gtl, Power_Board-F_Mask.gts, Power_Board-F_SilkS.gto, Power_Board.drl]
2015-07-11 Stencil Fixes
    Changed Solder Paste Clearance to 3mil.
    Changed SMD test points footprint to not have solder paste.
    Generated & ordered stencils.
    [Power_Board.kicad_pcb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]
2015-07-11 Stencil Fix
    Realized the solder paste clearance should be negative to bring it into
    the pads. Set to -0.001 to allow it to work even for small 0.5mm pitch
    components.
    [Power_Board.kicad_pcb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]
2015-07-11 Updated Template
    -Added default -0.001 paste clearance.
    -Added a reference copper pour so I won't have to remember the exact
    dimensions away from board edge.
    [opencamera-default.kicad_pcb]
2015-07-11 Fixed Template Ground Pour
    Now properly uses fillet corners to fully fill the board around mounting
    holes. Looks a lot nicer.
    [opencamera-default.kicad_pcb]
2015-07-12 Added more trace & via options to template.
    [opencamera-default.kicad_pcb]
2015-07-12 Created battery board schematic.
    [Battery_Board.kicad_pcb, Battery_Board.sch, connectors.sch]
2015-07-12 Added DNP Pull-Up Resistors.
    Just in case there is a need to pull-up the lines on-board.
    [Battery_Board.sch]
2015-07-12 Created & assigned footprints.
    [BOM.xlsx, Battery_Board.kicad_pcb, Battery_Board.sch, connectors.sch]
2015-07-13 Added power switch.
    [BOM.xlsx, Battery_Board.kicad_pcb, Battery_Board.sch]
2015-07-14 Initial part placement.
    Also added cutouts around the battery for a battery strap.
    [Battery_Board.kicad_pcb, Battery_Board.sch]
2015-07-15 Completed routing for battery board.
    No DRC errors!
    [Battery_Board.kicad_pcb]
2015-07-15 Ground plane cleanup.
    -Got rid of battery pour cutout on bottom layer.
    -Made the ground pour solid around the battery connector.
    [Battery_Board.kicad_pcb]
2015-07-16 Fixed cutouts & generated gerbers for battery board.
    -Cutouts were on the wrong layer
    -Bottom copper pour needed cutouts around the cutouts
    -Gerbers sent to fab!
    [Battery_Board-B_Cu.gbl, Battery_Board-B_Mask.gbs, Battery_Board-B_SilkS.gbo, Battery_Board-Edge_Cuts.gbr, Battery_Board-F_Cu.gtl, Battery_Board-F_Mask.gts, Battery_Board-F_SilkS.gto, Battery_Board.drl]
2015-07-25 Reference document reorganization
    Reorganizing datasheets and application notes now that I might be using
    the KAI-4021 sensor instead of the KAI-2020.
2015-08-03 Part Changes
    Fixes some mistakes made when choosing feedback resistors.
    R17: 1.8M -> 2.1M
    R18: 180k -> 210k
    R25: 20k -> 115k
    R20: 49.9k -> 523k
    [BOM.xlsx]
2015-08-03 Generated Battery Board Solder Paste Stencil.
    [Battery_Board.kicad_pcb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]
2015-12-30 Initialized Driver Board Schematic & PCB from template
    (also updated power board for the kicad version on my new computer)
    [Analog_Power.sch, Digital_Power.sch, Driver_Board.kicad_pcb, Driver_Board.sch, Power_Board.sch, connectors.sch]
2015-12-30 Updated connectors to reflect power board nets
    [Driver_Board.sch]
